benoittgt/hoerbert_hack/welding_mask.jpg

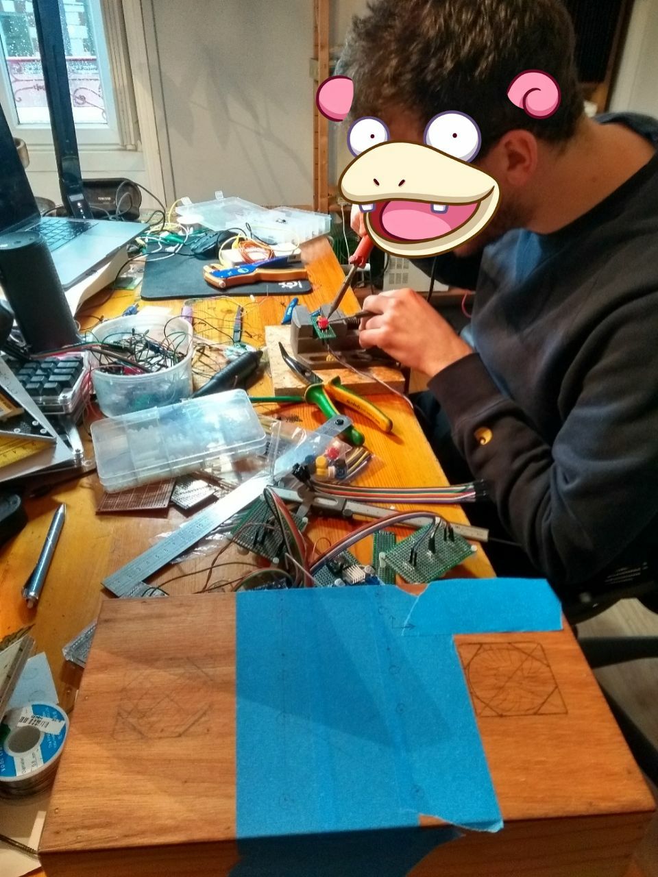
welding_mask.jpg
