benoittgt/hoerbert_hack/(commit log)

2018-12-24 Use correct type for long integer remove useless "lastAction" track
2020-11-29 Use new Arduino format file + tweak volume output to avoid crash
    I don't know why but volume was going louder than before then crashed
    the arduino. The arduino was restarting. I managed that by reducing the
    ouput volume.
    The sound at a very high level was with distorsion.
    [hoerbert_hack.ino]
